TheCacophonyProject/bluetooth-beacon-pcbs/esp32-beacon-receiver/esp32-beacon-receiver.kicad_pcb

## KiCad design esp32-beacon-receiver/esp32-beacon-receiver.kicad_pcb (2022-03-24)

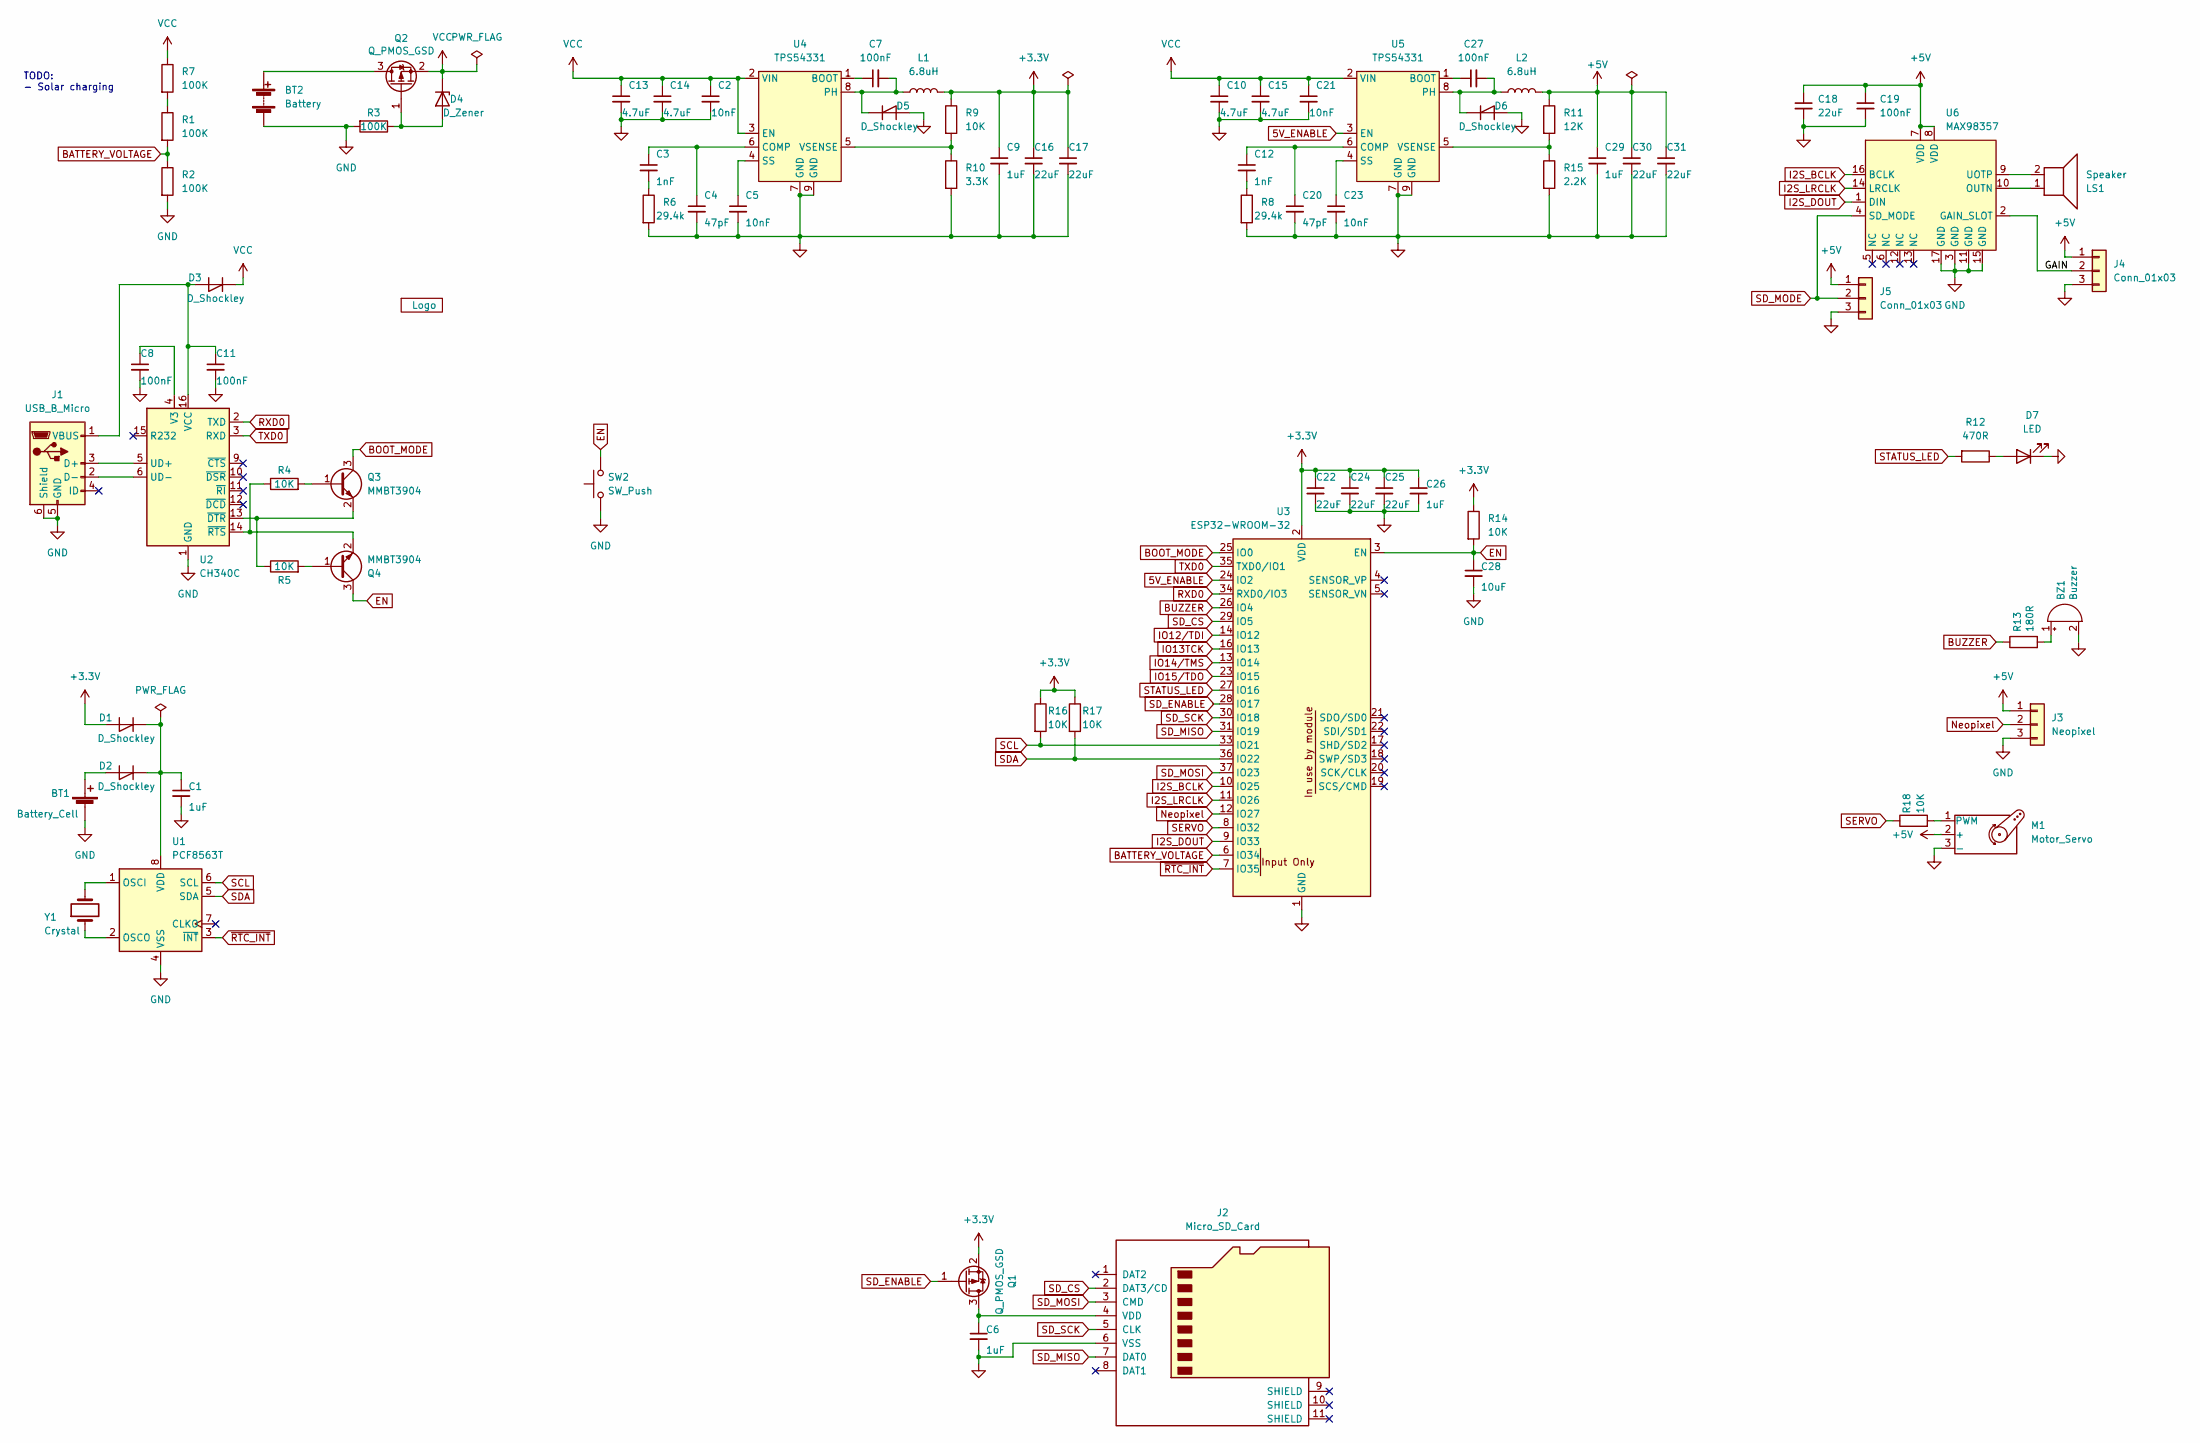
[picture p1: schematic esp32-beacon-receiver.kicad_sch]

Parts:
BT1: Battery_Cell; CR1220; LCSC C969906
BT2: Battery; PinSocket_1x02_P2.54mm_Vertical
BZ1: Buzzer; Buzzer_12x9.5RM7.6; LCSC C482357
C1, C6, C9, C26, C29: 1uF; C_0402_1005Metric; LCSC C52923
C2, C5, C21, C23: 10nF; C_0402_1005Metric; LCSC C15195
C3, C12: 1nF; C_0402_1005Metric; LCSC C1523
C4, C20: 47pF; C_0402_1005Metric; LCSC C1567
C7, C8, C11, C19, C27: 100nF; C_0402_1005Metric; LCSC C307331
C10, C13, C14, C15: 4.7uF; C_0402_1005Metric; LCSC C23733
C16, C17, C18, C22, C24, C25, C30, C31: 22uF; C_0805_2012Metric; LCSC C45783
C28: 10uF; C_0603_1608Metric; LCSC C19702
D1, D2, D3: D_Shockley; D_SOD-323; LCSC C191023
D4: D_Zener; D_SMA; LCSC C8062
D5, D6: D_Shockley; D_SMA; LCSC C22452
D7: LED; LED_0603_1608Metric; LCSC C2286
J1: USB_B_Micro; 920-E52A2021S10100; LCSC C10418
J2: Micro_SD_Card; SD_Micro; LCSC C585350
J3: Neopixel; PinSocket_1x03_P2.54mm_Vertical
J4, J5: Conn_01x03; PinSocket_1x03_P2.54mm_Vertical
L1, L2: 6.8uH; SWPA5040S; LCSC C36411
LS1: Speaker; PinSocket_1x02_P2.54mm_Vertical
M1: Motor_Servo; PinSocket_1x03_P2.54mm_Vertical
Q1, Q2: Q_PMOS_GSD; SOT-23; LCSC C15127
Q3, Q4: MMBT3904; SOT-23; LCSC C20526
R1, R2, R3, R7: 100K; R_0402_1005Metric; LCSC C25741
R4, R5, R9, R14, R16, R17, R18: 10K; R_0402_1005Metric; LCSC C25744
R6, R8: 29.4k; R_0402_1005Metric; LCSC C25890
R10: 3.3K; R_0402_1005Metric; LCSC C11457
R11: 12K; R_0402_1005Metric; LCSC C25744
R12: 470R; R_0402_1005Metric; LCSC C25117
R13: 180R; R_0603_1608Metric; LCSC C22828
R15: 2.2K; R_0402_1005Metric; LCSC C11457
SW2: SW_Push; SW_SPST_SKQG_WithStem; LCSC C318884
U1: PCF8563T; SOIC-8_3.9x4.9mm_P1.27mm; LCSC C7440
U2: CH340C; SOIC-16_3.9x9.9mm_P1.27mm; LCSC C84681
U3: ESP32-WROOM-32; JLCPCB C701343
U4, U5: TPS54331; SOIC-8-1EP_3.9x4.9mm_P1.27mm_EP2.29x3mm; LCSC C9865
U6: MAX98357; TQFN-16-1EP_3x3mm_P0.5mm_EP1.23x1.23mm; LCSC C910544
U7: Logo; logo
Y1: Crystal; Crystal_SMD_3215-2Pin_3.2x1.5mm; LCSC C32346

Connections:
5V_ENABLE: U3.24 (IO2), U5.3 (EN)
+3V3: C9.1, C16.1, C17.1, C22.1, C24.1, C25.1, C26.1, D1.2 (A), L1.2, Q1.2 (S), R9.1, R14.1, R16.1, R17.1, U3.2 (VDD)
+5V: C18.1, C19.1, C29.1, C30.1, C31.1, J3.1, J4.1, J5.1, L2.2, M1.2 (+), R11.1, U6.7 (VDD), U6.8 (VDD)
/GAIN: J4.2, U6.2 (GAIN_SLOT)
BATTERY_VOLTAGE: R1.2, R2.1, U3.6 (IO34)
BOOT_MODE: Q3.3 (C), U3.25 (IO0)
BUZZER: R13.1, U3.26 (IO4)
EN: C28.1, Q4.3 (C), R14.2, SW2.2, U3.3 (EN)
GND: BT1.2 (-), BT2.2 (-), BZ1.2 (+), C1.2, C2.2, C4.2, C5.2, C6.2, C8.2, C9.2, C10.2, C11.2, C13.2, C14.2, C15.2, C16.2, C17.2, C18.2, C19.2, C20.2, C21.2, C22.2, C23.2, C24.2, C25.2, C26.2, C28.2, C29.2, C30.2, C31.2, D5.2 (A), D6.2 (A), D7.1 (K), J1.5 (GND), J1.6 (Shield), J2.6 (VSS), J3.3, J4.3, J5.3, M1.3 (-), R2.2, R3.2, R6.2, R8.2, R10.2, R15.2, SW2.1, U1.4 (VSS), U2.1 (GND), U3.1 (GND), U3.15 (GND), U3.38 (GND), U3.39 (GND), U4.7 (GND), U4.9 (GND), U5.7 (GND), U5.9 (GND), U6.3 (GND), U6.11 (GND), U6.15 (GND), U6.17 (GND)
I2S_BCLK: U3.10 (IO25), U6.16 (BCLK)
I2S_DOUT: U3.9 (IO33), U6.1 (DIN)
I2S_LRCLK: U3.11 (IO26), U6.14 (LRCLK)
IO12/TDI: U3.14 (IO12)
IO13TCK: U3.16 (IO13)
IO14/TMS: U3.13 (IO14)
IO15/TDO: U3.23 (IO15)
Neopixel: J3.2, U3.12 (IO27)
unnamed: BT1.1 (+), D2.2 (A)
unnamed: BT2.1 (+), Q2.3 (D)
unnamed: BZ1.1 (-), R13.2
unnamed: C1.1, D1.1 (K), D2.1 (K), U1.8 (VDD)
unnamed: C3.1, C4.1, U4.6 (COMP)
unnamed: C3.2, R6.1
unnamed: C5.1, U4.4 (SS)
unnamed: C6.1, J2.4 (VDD), Q1.3 (D)
unnamed: C7.1, U4.1 (BOOT)
unnamed: C7.2, D5.1 (K), L1.1, U4.8 (PH)
unnamed: C8.1, U2.4 (V3)
unnamed: C11.1, D3.2 (A), J1.1 (VBUS), U2.16 (VCC)
unnamed: C12.1, C20.1, U5.6 (COMP)
unnamed: C12.2, R8.1
unnamed: C23.1, U5.4 (SS)
unnamed: C27.1, U5.1 (BOOT)
unnamed: C27.2, D6.1 (K), L2.1, U5.8 (PH)
unnamed: D4.2 (A), Q2.1 (G), R3.1
unnamed: D7.2 (A), R12.1
unnamed: J1.2 (D-), U2.6 (UD-)
unnamed: J1.3 (D+), U2.5 (UD+)
unnamed: LS1.1, U6.10 (OUTN)
unnamed: LS1.2, U6.9 (UOTP)
unnamed: M1.1 (PWM), R18.2
unnamed: Q3.1 (B), R4.2
unnamed: Q3.2 (E), R5.1, U2.13 (~DTR)
unnamed: Q4.1 (B), R5.2
unnamed: Q4.2 (E), R4.1, U2.14 (~RTS)
unnamed: R1.1, R7.2
unnamed: R9.2, R10.1, U4.5 (VSENSE)
unnamed: R11.2, R15.1, U5.5 (VSENSE)
unnamed: U1.1 (OSCI), Y1.2
unnamed: U1.2 (OSCO), Y1.1
RXD0: U2.2 (TXD), U3.34 (RXD0/IO3)
SCL: R16.2, U1.6 (SCL), U3.33 (IO21)
SDA: R17.2, U1.5 (SDA), U3.36 (IO22)
SD_CS: J2.2 (DAT3/CD), U3.29 (IO5)
SD_ENABLE: Q1.1 (G), U3.28 (IO17)
SD_MISO: J2.7 (DAT0), U3.31 (IO19)
SD_MODE: J5.2, U6.4 (SD_MODE)
SD_MOSI: J2.3 (CMD), U3.37 (IO23)
SD_SCK: J2.5 (CLK), U3.30 (IO18)
SERVO: R18.1, U3.8 (IO32)
STATUS_LED: R12.2, U3.27 (IO16)
TXD0: U2.3 (RXD), U3.35 (TXD0/IO1)
VCC: C2.1, C10.1, C13.1, C14.1, C15.1, C21.1, D3.1 (K), D4.1 (K), Q2.2 (S), R7.1, U4.2 (VIN), U4.3 (EN), U5.2 (VIN)
~RTC_INT: U1.3 (~INT), U3.7 (IO35)

Notes on the sheet:
TODO: - Solar charging

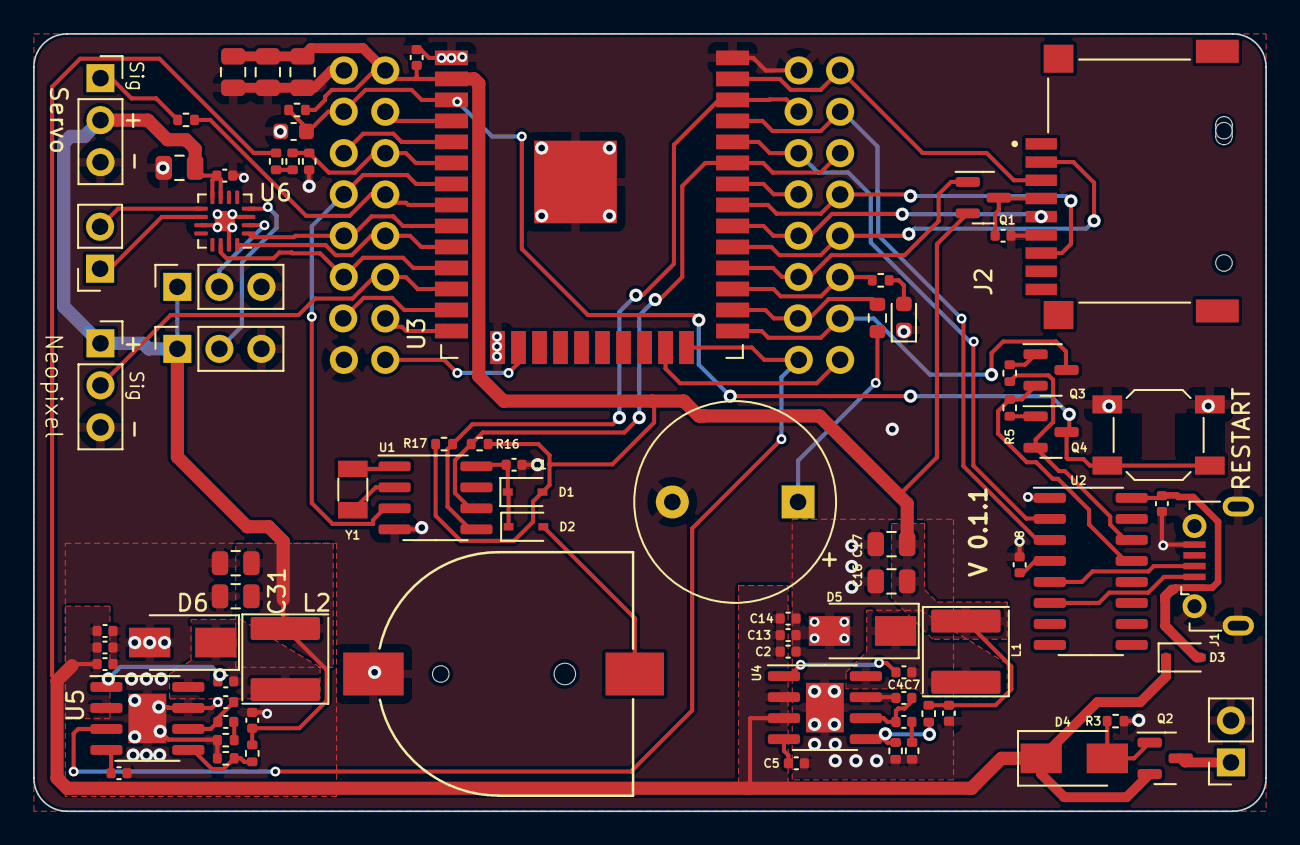
[picture p2: board esp32-beacon-receiver.kicad_pcb from above]

Board: 2 copper layers, 74.5 x 47.0 mm, 81 parts (1 on the bottom side), 60 nets.
